JuKimpfler/FullBridge_LowVoltage_SSTC/FullBridge.png

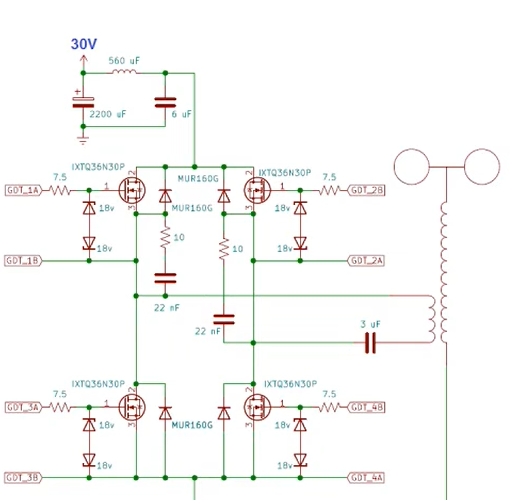
FullBridge.png
