JuKimpfler/FullBridge_LowVoltage_SSTC/Schematics_Vorbild.jpg

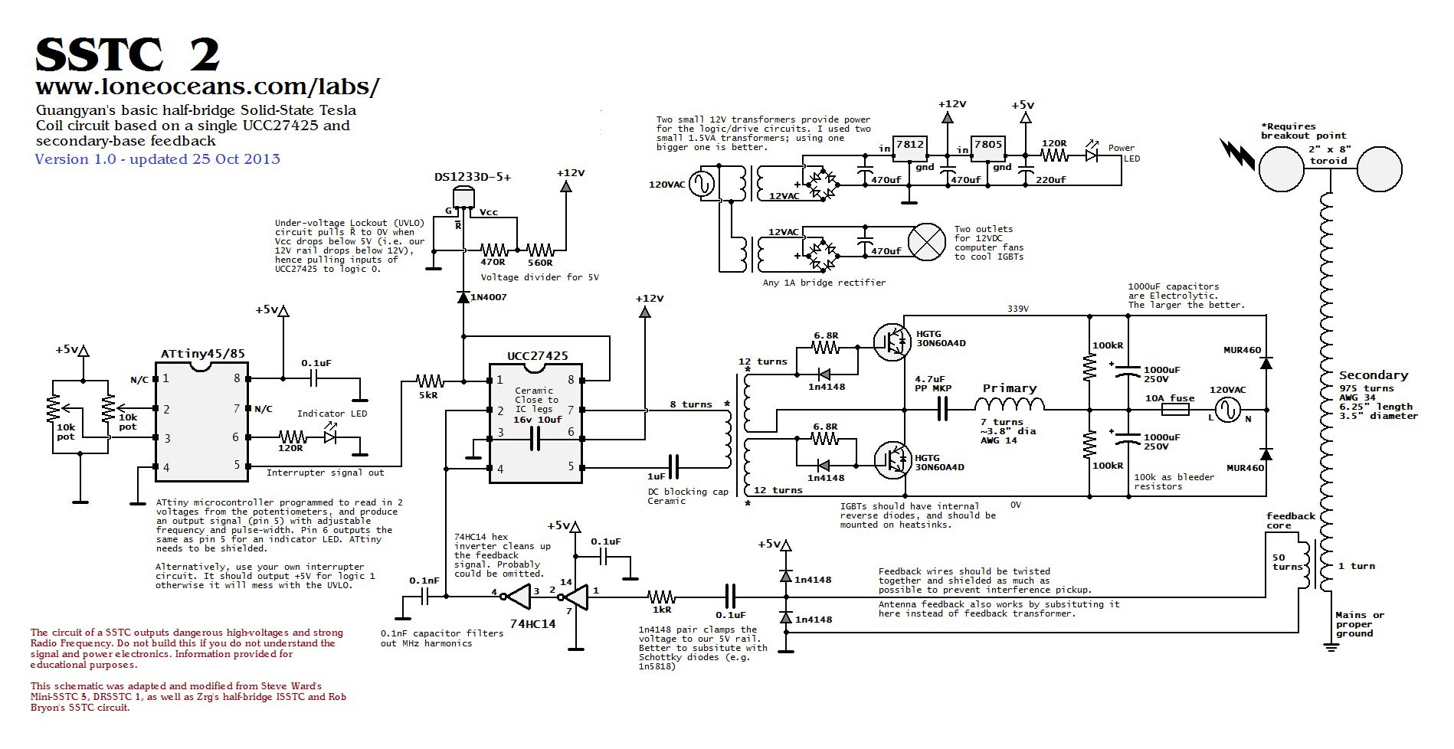
Schematics_Vorbild.jpg
