JuKimpfler/FullBridge_LowVoltage_SSTC/(notices)

Notices in the files:
parts and their libraries:
74HC14: COPYRIGHT: Copyright (C) 2026 Ultra Librarian. All rights reserved.
